Chaeng3/ComputerScreen/docs/legacy-oled.md

# ComputerScreen · 旧版 OLED 使用说明




此项目使用ESP32+OLED实现电脑副屏功能，开机时实时显示CPU、RAM、GPU占用率（API由AIDA64提供）。关机时显示时钟信息。

---

准备阶段：
硬件：
* ESP32芯片*1，¥25.25，淘宝链接：https://item.taobao.com/item.htm?id=672317019032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
* OLED2.42寸 5针 3.3V 白色*1，¥95.2，淘宝链接：https://detail.tmall.com/item.htm?id=558395483864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
* 杜邦线*4，根据机箱需要设置长度，价格忽略不计。
* 
* USB-TypeC线*1，根据机箱需要设置长度，价格忽略不计。
* 扩展板9针USB主板内置USB口*1(不必需），¥8，淘宝链接：https://detail.tmall.com/item.htm?id=736189528051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




软件：
* AIDA64，¥1.88可激活，淘宝链接：https://item.taobao.com/item.htm?id=625367245693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
* Arduino，免费。

---

操作阶段：
* 1.电脑设置AIDA64，参考文献：https://blog.csdn.net/weixin_42487906/article/details/119990801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
* 注意如图勾选5个输出项：QQ_1722665863713
* 2.连接硬件，ESP32-OLED：SCL-GPIO21，SDA-GPIO22，VCC-3.3V，GND-GND。
* 3.写入代码。

---

下面是设备的更新日志：
* 2.92 解决时钟模式时间不准确问题。
* 2.91 取消仪表盘模式下时间显示秒数，界面更流畅。
* 2.9 解决时钟模式下秒数跳秒问题，改为每小时校对时间一次。修改时钟模式下，星期显示不完整问题。
* 2.8 解决时间模式下星期显示不完整问题。
* 2.7 更换汽车仪表盘外观。
* 2.6 优化电脑关机后没有进入时钟逻辑。
* 2.5 时间显示更大的字体。
* 2.4 时钟增加星期。
* 2.3 电脑关机时，使用ntp.aliyun.com显示电子时钟。串口增加命令“aclock”测试电子时钟效果，1分钟后返回。
* 2.2 屏幕旋转180。
* 2.1 增加百分比文字。增加三个图形的间隔。
* 2.0 增加图形处理，使用半圆代表百分比。
* 1.0 完成基本文字输出。
