Chaeng3/ComputerScreen/docs/images/case-screen-early-2.jpg

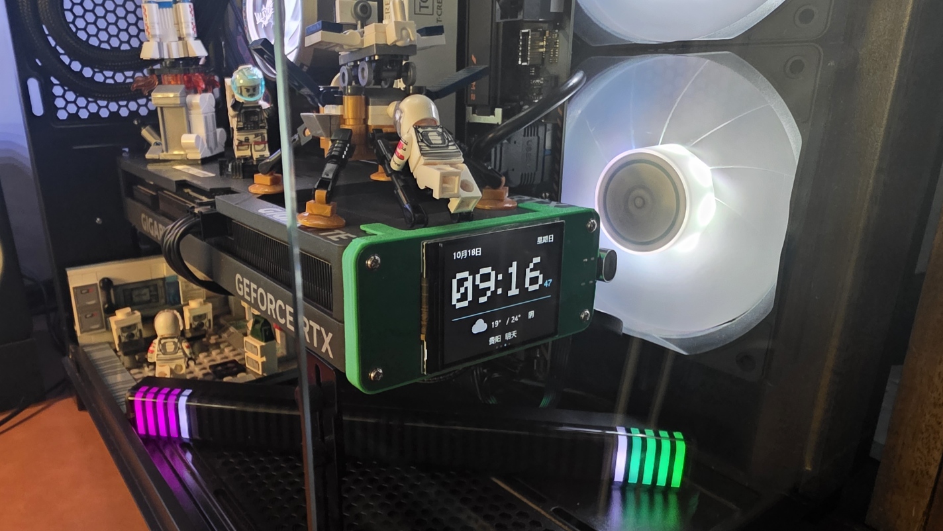
docs/images/case-screen-early-2.jpg
