Chaeng3/ComputerScreen/docs/images/ComputerScreen-showcase-1.jpg

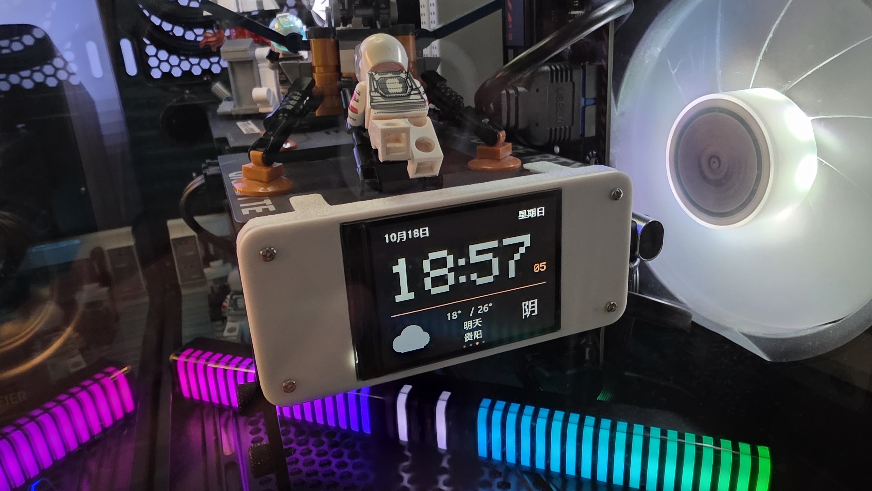
docs/images/ComputerScreen-showcase-1.jpg
