Chaeng3/ComputerScreen/docs/images/ComputerScreen-showcase-4.jpg

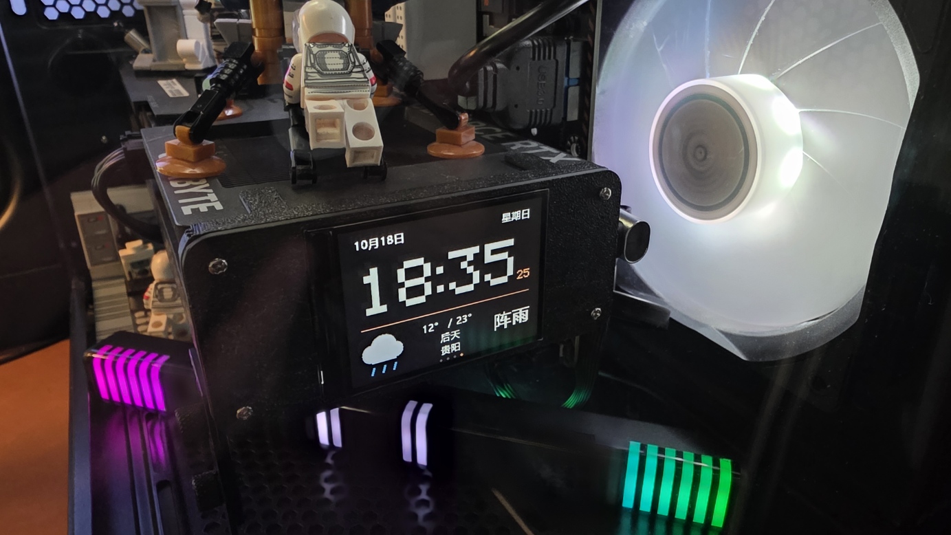
docs/images/ComputerScreen-showcase-4.jpg
