Chaeng3/ComputerScreen/docs/images/ComputerScreen.jpg

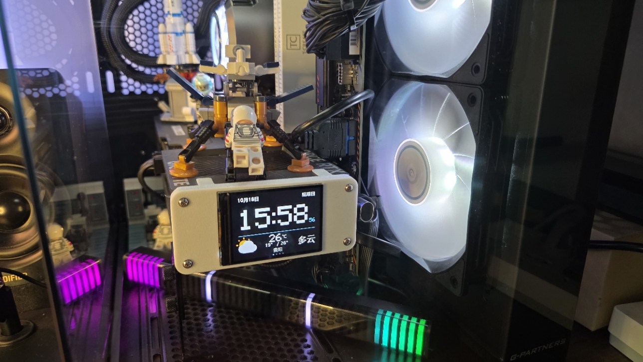
docs/images/ComputerScreen.jpg
