Chaeng3/ComputerScreen/firmware/assets/themes/concept-board.png

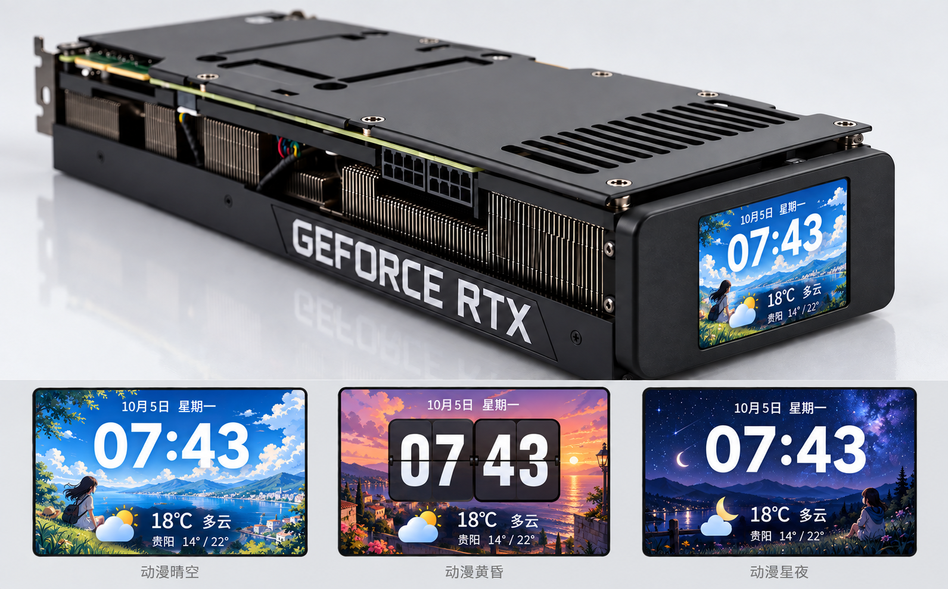
firmware/assets/themes/concept-board.png
