Chaeng3/ComputerScreen/firmware/assets/themes/day.png

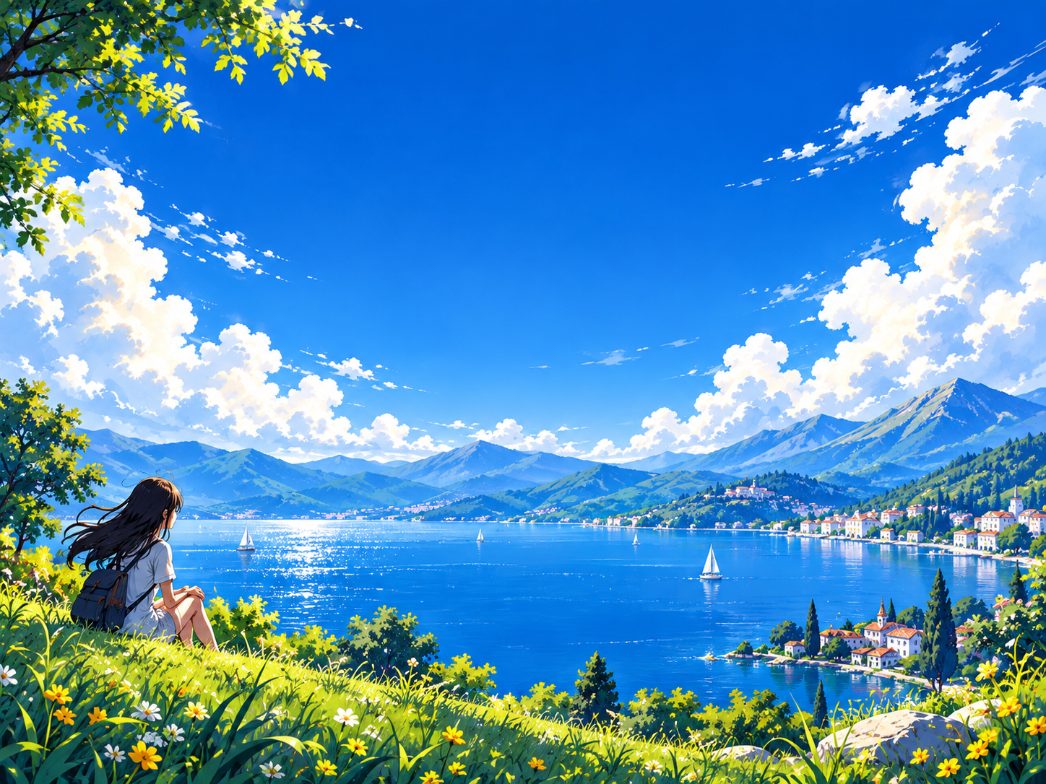
firmware/assets/themes/day.png
