Chaeng3/ComputerScreen/firmware/assets/themes/dusk.png

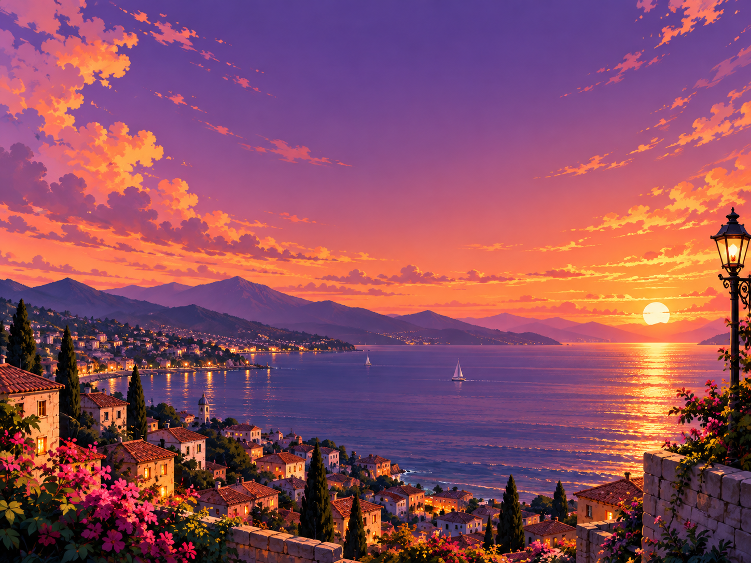
firmware/assets/themes/dusk.png
