Chaeng3/ComputerScreen/firmware/assets/themes/night.png

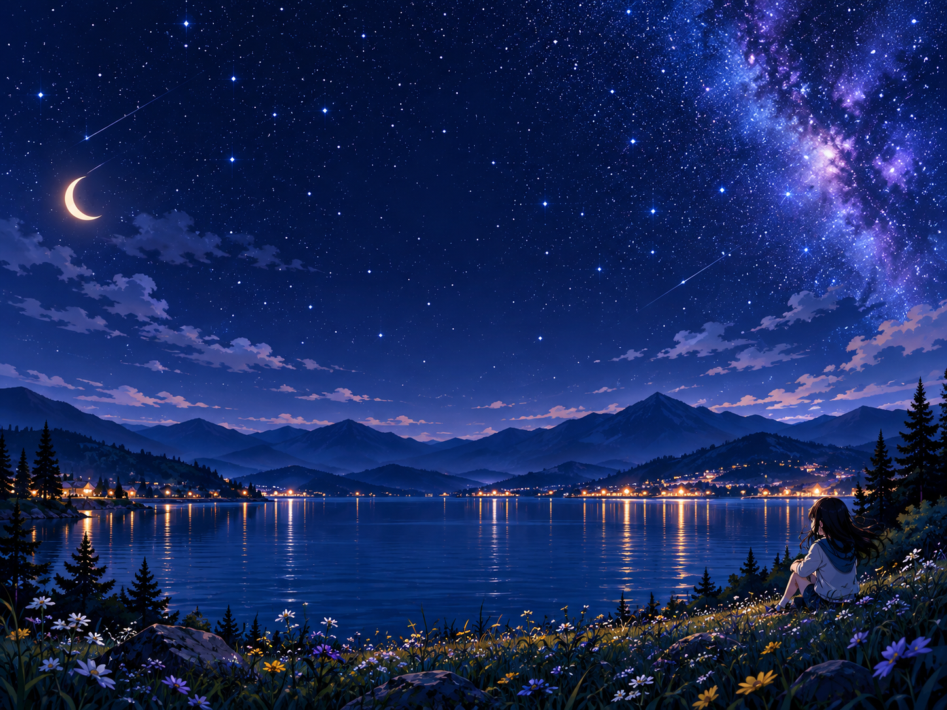
firmware/assets/themes/night.png
