Chaeng3/ComputerScreen/hardware/BOM_Board1_PCB1_2026-10-17.xlsx

No. | Quantity | Comment | Designator | Footprint | Value | Manufacturer Part | Manufacturer | Supplier Part | Supplier
1 | 2 | TS-1088-AR02016 | BOOT,RST | SW-SMD_L3.9-W3.0-P4.45 |  | TS-1088-AR02016 | XUNPU(讯普) | C720477 | LCSC
2 | 1 | 22uF | C1 | C0805 | 22uF | CL21A226MAQNNNE | SAMSUNG(三星) | C45783 | LCSC
3 | 4 | 10uF | C2,C4,C6,C10 | C0805 | 10uF | CGA0805X5R106K250MT | HRE(芯声) | C6119887 | LCSC
4 | 5 | 100nF | C3,C5,C7,C8,C11 | C0805 | 100nF | FCC0805B104K500DT | FOJAN(富捷) | C5137467 | LCSC
5 | 1 | 1uF | C9 | C0805 | 1uF | CL21B105KBFNNNE | SAMSUNG(三星) | C28323 | LCSC
6 | 1 | FPC-05F-12PH20 | FPC1 | FPC-SMD_12P-P0.50_FPC-05F-12PH20 |  | FPC-05F-12PH20 | XUNPU(讯普) | C2856799 | LCSC
7 | 1 | 2.2uH | L1 | IND-SMD_L3.0-W3.0_FNR30XXS | 2.2uH | FNR3015S2R2MT | cjiang(长江微电) | C167747 | LCSC
8 | 1 | UMH3N | Q1 | SC-70-6_L2.2-W1.3-P0.65-LS2.1-BR |  | UMH3N | CJ(江苏长电/长晶) | C62892 | LCSC
9 | 1 | SS8050 | Q2 | SOT-23-3_L2.9-W1.3-P1.90-LS2.4-BR |  | SS8050 | R+O(宏嘉诚) | C7420370 | LCSC
10 | 1 | 1kΩ | R1 | R0805 | 1kΩ | 0805W8F1001T5E | UNI-ROYAL(厚声) | C17513 | LCSC
11 | 1 | 680kΩ | R2 | R0805 | 680kΩ | 0805W8F6803T5E | UNI-ROYAL(厚声) | C17797 | LCSC
12 | 2 | 5.1kΩ | R3,R5 | R0805 | 5.1kΩ | 0805W8F5101T5E | UNI-ROYAL(厚声) | C27834 | LCSC
13 | 1 | 150kΩ | R4 | R0805 | 150kΩ | 0805W8F1503T5E | UNI-ROYAL(厚声) | C17470 | LCSC
14 | 3 | 10kΩ | R6,R7,R9 | R0805 | 10kΩ | FRC0805J103TS | FOJAN(富捷) | C2930231 | LCSC
15 | 1 | 2.2kΩ | R8 | R0805 | 2.2kΩ | 0805W8F2201T5E | UNI-ROYAL(厚声) | C17520 | LCSC
16 | 4 | M2螺丝 | SCREW1,SCREW2,SCREW3,SCREW4 | M2螺丝
17 | 1 | CH340C | U1 | SOP-16_L10.0-W3.9-P1.27-LS6.0-BL |  | CH340C | WCH(南京沁恒) | C84681 | LCSC
18 | 1 | TLV62568DBVR | U2 | SOT-23-5_L3.0-W1.7-P0.95-LS2.8-BR |  | TLV62568DBVR | TI(德州仪器) | C163219 | LCSC
19 | 1 | XL-2012BGWC | U3 | LED0805-RD_BLUE |  | XL-2012BGWC | XINGLIGHT(成兴光) | C965819 | LCSC
20 | 1 | ESP32-S3-WROOM-1-N16R8 | U4 | WIRELM-SMD_ESP32-S3-WROOM-1 |  | ESP32-S3-WROOM-1-N16R8 | ESPRESSIF(乐鑫) | C2913202 | LCSC
21 | 1 | TYPE-C16PIN | USB1 | USB-C-SMD_TYPE-C16PIN |  | TYPE-C16PIN | SHOU HAN(首韩) | C393939 | LCSC
