Chaeng3/ComputerScreen/hardware/enclosure/V2底座.step

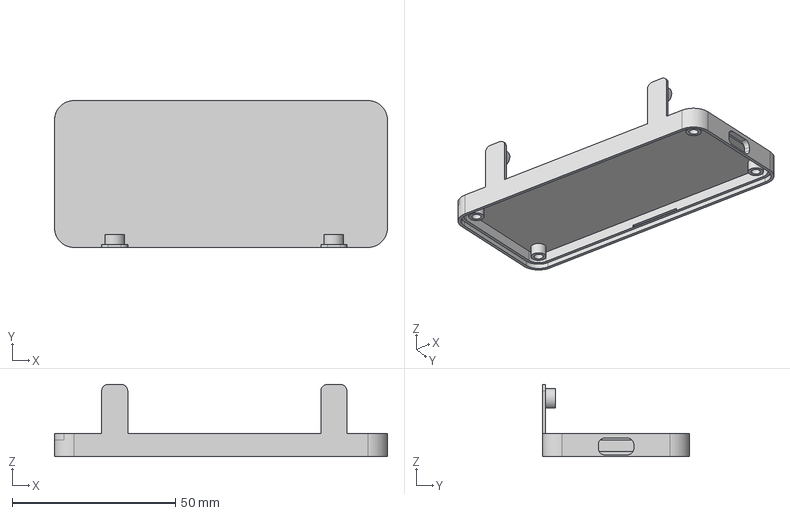
[picture p10: CAD file, 2026-10-18]
hardware/enclosure/V2底座.step
102.0 x 45.0 x 22.1 mm
