Chaeng3/ComputerScreen/hardware/enclosure/V2顶盖.step

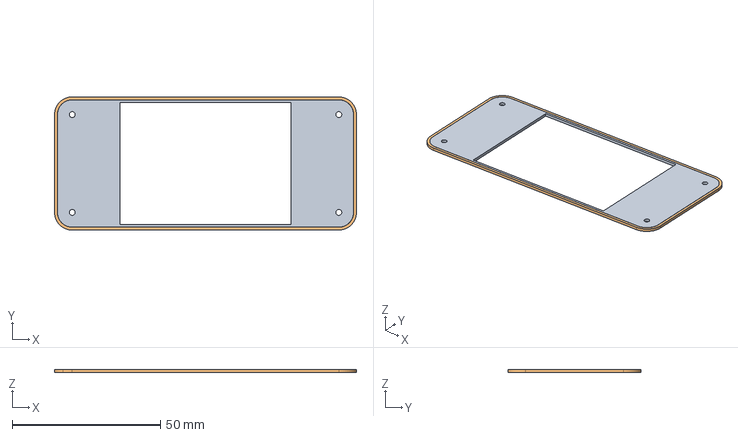
[picture p11: CAD file, 2026-10-18]
hardware/enclosure/V2顶盖.step
102.0 x 45.0 x 1 mm
