Chaeng3/ComputerScreen/firmware/main/board.h

#pragma once

// Netlist_Schematic1_2026-10-17.tel; screen connector numbering is reversed.
#define LCD_PIN_MOSI 11
#define LCD_PIN_CLK 12
#define LCD_PIN_CS 10
#define LCD_PIN_DC 13
#define LCD_PIN_RST 14
#define LCD_PIN_BL 21
#define LCD_WIDTH 320
#define LCD_HEIGHT 240
#define LCD_SPI_HZ (20 * 1000 * 1000)
#define LCD_MIRROR_X 0
#define LCD_MIRROR_Y 1
#define LCD_INVERT_COLORS 1

// Netlist_Schematic1_2026-11-09.tel
#define AHT_PIN_SCL 1
#define AHT_PIN_SDA 2
#define STATUS_LED_PIN 38
#define EFFECT_LED_PIN 7
#define MIC_PIN_SCK 4
#define MIC_PIN_WS 5
#define MIC_PIN_SD 6
