Chaeng3/ComputerScreen/firmware/main/city_ids.h

// Generated from Seniverse official city list (2026-07-02).
#pragma once
static const char *const mainland_city_ids[] = {
    "WX4FBXXFKE4F",
    "WWGQDCW6TBW1",
    "WWC2MYYCM6J5",
    "WXH13WQT7XKN",
    "WXJ51T411GRX",
    "WW92M43YCQG0",
    "WW96VH3U3KG5",
    "WWFJ5S4DNJ0T",
    "WX38NPJ1DP88",
    "WX7C5D6581T3",
    "WWG1FS318M6P",
    "WX4BZD6KEJFY",
    "WWDQ8KE95MGB",
    "WW8P3NH2TPDT",
    "WX0S40QDCME0",
    "WW8Z267HHZ3U",
    "WW2MYN52R11E",
    "WW23BS9T8PB1",
    "WQZZWRV1BGKH",
    "WW8NMEQJCMJE",
    "WQNZJRJNM3JV",
    "WWB4T4PKXRH7",
    "WQRM38NMHR7P",
    "WQXJ2UGJEGPU",
    "WRR2Q2Z7CXWM",
    "WRNP70PG2MPX",
    "WR5CWTXYQRVP",
    "WXS86P4BSG4G",
    "WXYBNKF2CT25",
    "WRN16S9GJRQ1",
    "Y8TPTQNF5V3X",
    "WRHRG8C39PEC",
    "WX23NNWFJD1D",
    "Y8NY1ECCRVK4",
    "WXF9BT6Y0JY4",
    "WQGJJBDMKH1Z",
    "WXRVB9QYXKY8",
    "WWYMRT0VRMUG",
    "WXR3Y6P2CEQ3",
    "WZ2NM0P2XMU7",
    "WZ24BQQTFN10",
    "WZ0KQ36Y0N4N",
    "WXQ1U6H0VE63",
    "WXNZM7TPVMMZ",
    "WXQX09T2HRXX",
    "WXRDFBCXJJ8E",
    "WXQCCV8TM5T4",
    "WZ809BF6B5HR",
    "WXMSKZT4B3TT",
    "WXJZTSCEPN4J",
    "WZC1EXZ0P9HU",
    "WZCCRENBK8PQ",
    "WZ8MTDUGMP22",
    "WZ8GZQHFH76E",
    "WZ3T3SEQVEVF",
    "WZ3YSC05ZW82",
    "YB0B8REJKCCB",
    "Y8P7E0F5F2QK",
    "WZS5FZSMRDT6",
    "YB1UX38K6DY1",
    "YB2JK81THR6Z",
    "YBJ1SQ97WHN1",
    "YBKTK25TPP2R",
    "YBM322SX2QPB",
    "YB2BVPSH4JM5",
    "YB7XT0YP7SYK",
    "YBKDQEKD30TF",
    "YBJH7VFZU4T1",
    "WZUJT5EC6FK4",
    "YBFTUGSP7QCT",
    "YB63388P2QN8",
    "YBBQB6TMV95Z",
    "WTW3SJ5ZBJUY",
    "WTSQQYHVQ973",
    "WTTE97PU94T9",
    "WW56FQXV5ZHB",
    "WTTKC92GVT6S",
    "WTTDPCGXTWUS",
    "WTTVYTY1H0HF",
    "WWHUBFTRE77P",
    "WTUXK27DXN0R",
    "WTVMWP4TCFT7",
    "WTUBM40RTTUB",
    "WTSZNJUFDEP9",
    "WTV28G74FW3J",
    "WWH1780CEFBR",
    "WTMKQ069CCJ7",
    "WTQ3VZQP879N",
    "WSVZ695PCF71",
    "WTMYGTZ7WZMY",
    "WTMRU3PTDC3X",
    "WTMDXTK6STK4",
    "WTJJ6TY7R0FK",
    "WTHS8FW3RYBK",
    "WTQFSTR6DMK4",
    "WTN74CS48NB0",
    "WTJ3BG5J683H",
    "WTEMH46Z5N09",
    "WTS4JZ3WMZMC",
    "WTG7R0CSBHZ9",
    "WTG1WKHG98G5",
    "WTSK2DC1FHK3",
    "WW511U7JJ68Q",
    "WT7ZCN9UKCZS",
    "WT7JXTC4NSMZ",
    "WTK1H2DTJ1U4",
    "WTSPU2JCPU6T",
    "WTF75T383SE2",
    "WTGPMFNHZW6H",
    "WTDUEP89WV0P",
    "WW42DDHQT937",
    "WT7W3R63DQMH",
    "WTS2N4R0GD1V",
    "WSSU6EXX52RE",
    "WS7GQBRNR6V8",
    "WSS8S6CQZBPG",
    "WSETKW23BDUT",
    "WSKMS3KBE2JM",
    "WS7EMPWP7EQ3",
    "WSSP952Z8846",
    "WS7NZ16DHEHU",
    "WSSZXXPU1B76",
    "WT47HJP3HEMP",
    "WT5QD22W4GKR",
    "WSBVNTZH3M2C",
    "WT62ZWSX5CM0",
    "WSCWR06PNPFU",
    "WT50ZFRU8TYY",
    "WS9DZQ1QXHGR",
    "WSCF23JCKNQJ",
    "WSCQ4UBFXPTE",
    "WSFXR95RZD21",
    "WT5CU7PJK0RS",
    "WWE0TGW4PX6N",
    "WWMT5Q64CR3G",
    "WWECQQCKH37Z",
    "WW5QJDVC4NKQ",
    "WWSKUMUVE3TR",
    "WWWM51WDH1FX",
    "WWS8Z342UPZ7",
    "WW6CSB4BQYSD",
    "WW7MBNP039PE",
    "WWWV6YM1F4ZV",
    "WWKCX8PB3YE6",
    "WWHPMHEV4CS4",
    "WWDTN3X443VR",
    "WW6RR5W09UKP",
    "WWEUSKZ4K1P9",
    "WW607X60CDS4",
    "WW0V9QP93VS8",
    "WW1MBZNSXN1M",
    "WQPUYY7S4GV2",
    "WW02P7XHT0KB",
    "WW3M6GBCXPV8",
    "WW372S04V500",
    "WW2BZF5MQKGW",
    "WW2835D5K7BE",
    "WW3G3XDR3729",
    "WW0CWDZP17BC",
    "WTCP494CDTDN",
    "WQPJF7T25VCT",
    "WTB58RQWFJC5",
    "WW45ZXMVB36N",
    "WT9NG9P4ZDHG",
    "WTCX2BMDDWHP",
    "WTC5DEFF6TD5",
    "WW0P9B6381U6",
    "WT3Q0FW9ZJ3Q",
    "WT3GC9DRC209",
    "WMYC8VK3H18J",
    "WMRNSHZ87YY1",
    "WMXY3PVX93RV",
    "WT3SYNJHF48X",
    "WMXB90VDC7PZ",
    "WT3PBQDH23US",
    "WMRU9C7MH9C3",
    "WT3TJZMB152J",
    "WT33C6J2C563",
    "WT8S7Y3W2KX4",
    "WMMU75CW7CKH",
    "WT2SV8EY0D76",
    "WT2M09U9QEH8",
    "WT2QRPRCSNKH",
    "WMW7Q9T3W529",
    "WT029G15ETRJ",
    "WSBQQ66C8040",
    "WSBQ3F31E8P0",
    "WSB118FZZ57Y",
    "WKZ7089YZ20M",
    "WT0RN4EKXHCD",
    "WMPMM26US87X",
    "WMNT9YCY99D6",
    "WMPFEYKZJDQM",
    "WS86EV4EKUK4",
    "WKXQ7GRJYT07",
    "WKYHZ4GWCU8B",
    "WKZTU85FVNSV",
    "WMN114DHVC2T",
    "WS0E9D8WN298",
    "WS2V1N2FZZ77",
    "WS10730EM8EV",
    "WEBY8Q5HHUCU",
    "WS4UZ4EZ953Z",
    "WS06YNEMPP18",
    "WS02MNW64CP6",
    "W7Y3P046TR7U",
    "W7YGK0CKZKF9",
    "WKPGPK45UZQM",
    "WS17E8Y5G0RU",
    "WS6D4KH12059",
    "WS4196CZ5GG1",
    "WS1WFPCVR8WG",
    "W7ZSKJM3GP7Z",
    "WS0QU43YTBHW",
    "WS0GHKN5ZP7T",
    "WS08H58U92R8",
    "WEEJ79ZFGR3H",
    "WS4YTUBPDZY9",
    "WS4VBP4H9W1J",
    "WKPDMK3Y8JWT",
    "WKJ1F428HH2F",
    "WKMF3VJHWB9X",
    "WKQRV6P6WM81",
    "WKPJS42KFVJX",
    "W7VD5N6F061Q",
    "W7V53W659VPW",
    "W7VHZEYSJ2W6",
    "WKJGQJ0R3057",
    "WKN2DZXM71F0",
    "WK5ZFNY7D4FJ",
    "WKR6FMS0Z3UW",
    "WKKUE0QPVT8X",
    "WKJWVXFV72X7",
    "W7UR7MB3QQDU",
    "W7W3YQKE4QDH",
    "W7JZGDR3YYTF",
    "W6ZZU0E5REV5",
    "W7MZJ3D2NP9X",
    "W7MFU4Y12VWZ",
    "W7QT9B3G3S46",
    "W7QZ1QFP50HH",
    "W7QDBNQVFQN8",
    "W7MHXVJCW6NC",
    "W7W2N6K8F64J",
    "W7QQ1QHQ7VWQ",
    "W7W0PPEX9F8F",
    "W7TCRF6D3JPS",
    "W7MV6SENCGG4",
    "W7MT92RG3HJD",
    "W7MDSJR4TMK4",
    "W7Q1PZC6KCFW",
    "W7Q1BR3PE78W",
    "W7QH70RCB3PE",
    "WM7B0X53DZW2",
    "WM6N2PM3WY2K",
    "WM4WBR42NUWC",
    "WK8R4WWPXZ1K",
    "WM4UPPEGCN1F",
    "WMD1P5P1QK95",
    "WMD7P0YN1CHN",
    "WMG22PXN3WPT",
    "WM7JD7CXZK37",
    "WM68Q2Z5FRTM",
    "WM3B1R518R80",
    "WM7RJGM47PV5",
    "WM3FFWQTYQ52",
    "WM47STMVQSWN",
    "WM7V66VSE5DV",
    "WMS3W5RJETCF",
    "WM34XCDQ1VND",
    "WMEVJW5E9Q66",
    "WM67M75V9WZY",
    "WMB74JR8MU82",
    "WJX5GH5PYG5R",
    "WKBWQZEYXGPF",
    "WKEZD7MXE04F",
    "WKDX33TQ96BZ",
    "WKUJ8GKSN3ZC",
    "WKEM6FWMMFWJ",
    "WKFG79YD1BCG",
    "WKVTSQQ2WQS8",
    "WK6WEPSTQ9P5",
    "WKSZ3058QEG5",
    "WKSMQSH1JQT7",
    "WK3N92NQV6RQ",
    "WK9C440U729C",
    "WK2FT8F9H0YR",
    "WHQWBSVQS7RS",
    "WKCG2PQ8G1M2",
    "WHZ2BV37270V",
    "WHPG4ZZB3XSN",
    "WHPPV7HP148U",
    "WK2NQUD6QD0J",
    "WK1KZS3MC5U1",
    "WK4HUQ2S15F0",
    "W5ZTJWVFU2BB",
    "WHX38U36B3BU",
    "WHQ5514S00XF",
    "WHW713U75VQ2",
    "WHYYKBBJHGP4",
    "WJ2B9TWGFBT5",
    "TVPNW82QN57R",
    "WJT157H36HS5",
    "WJ70G7N4S3H0",
    "WJ1Q3KPFD1QS",
    "WJ97P4G263RF",
    "TV9JG0M1S9QU",
    "WQJ6YY8MHZP0",
    "WQJQWC27HZX1",
    "WQH5TBCEVBMU",
    "WQJ7398FTXFD",
    "WQJU78X3NFJU",
    "WQTB5QBFKYSB",
    "WMUH5K1WDWZC",
    "WQY1BBWVNM4Q",
    "WMV9BV1YY1EC",
    "WQN0TV21C6RY",
    "WQ3V4QR6VR6G",
    "WPJFKJQ5BCWZ",
    "WQBEJ0TNY84M",
    "WQ6PFTTX1VY6",
    "WQ5HTXNGNE1W",
    "WQ8ZZ2UYK26X",
    "WNZMMYCRWTUZ",
    "WQ7F5V8HRBZU",
    "WPN41UK0D3H6",
    "WQKE38EK0NBP",
    "WQ66KU06BHB1",
    "WMFTU75WU2CG",
    "WQ36SBF902FR",
    "WQ1PJB8R8EFB",
    "WQ82K43YVYU8",
    "WQ2Y3RYEE7DY",
    "WNXF241JU7T0",
    "WQ2D1TXVBJ01",
    "WNRW6560ZURV",
    "WNPK15RJ0H84",
    "WJUGXXRYCVG7",
    "WNTHRYRP0P8J",
    "WQGDF7NXZRZB",
    "WQGTUXRECXJN",
    "WQG80DH3X35S",
    "WQ7SF3WEPQRU",
    "WQDV3QM9ZDUM",
    "TZY33C4YJBP3",
    "VBH77M0RQ24G",
    "TZXKM4G9GS71",
    "WPDE8HGNVFWJ",
    "TZY46T9GJ6Y0",
    "TZFR7QSK5DH2",
    "TZMM84XHV4GU",
    "TZ344WFBDS60",
    "TXN1VJTX2P0K",
    "TXN08CQCQM63",
    "TY8G4T7ZWVX1",
    "TZCCFD84WXV4",
    "VB71BQ84QPSS",
    "VBW8JQY63YDB",
    "TZVHJ8T4HQ93",
    "TZ1Y9TFKC7BS",
    "TZ04Z1NF3P4V",
    "TZY7200FWT0M",
    "VBQMNXK3YFKV",
    "TZKYJKV2ZPNW",
    "TZFX1GQY86PS",
    "TZC9UPSYFNPD",
    "TY87SMB6KKFW",
    "TZUQ6KHGBB5U",
    "WPDEMHMT41PP",
    "VB6CY6V0NSYW",
    "TWYP9BUH6RSM",
};
