Chaeng3/ComputerScreen/(commit log)

2026-10-18 Add ESP32-S3 weather clock v1.3.0 with web OTA
2026-10-18 Number the current ESP32-S3 release as v3.3.0
